opmatrixlabs/TeensyTimeServer/(commit log)

2026-08-26 Add project files.
    [writerside.cfg]
2026-08-30 Version 3.0
    [writerside.cfg]
