opmatrixlabs/TeensyTimeServer/(notices)

Notices in the files:
TimeHttp.h:
The MIT License (MIT)
